tame0001/circuit/README.md

# CircuitDesign
Repository to keep electronics circuit design
