tame0001/circuit/LED/led_v1/led_v1.kicad_pcb

## KiCad design LED/led_v1/led_v1.kicad_pcb (2022-02-28)

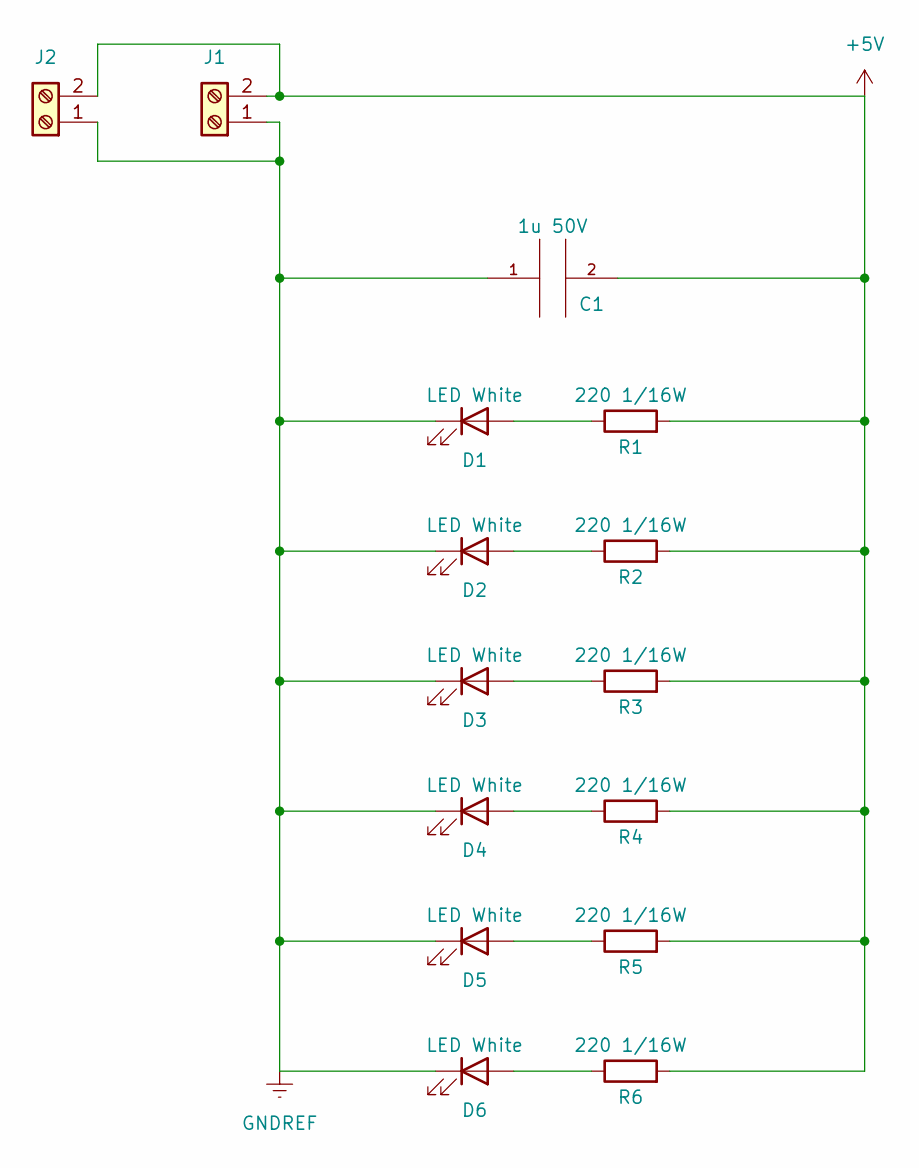
[picture p1: schematic led_v1.kicad_sch, LED Strip]

Parts:
C1: 1u 50V; C_0805_2012Metric; Part Number CL21B105KBFNNNE; JLC 0805
D1, D2, D3, D4, D5, D6: LED White; LED_0603_1608Metric; Part Number 19-217/T1D-CQ2R2TY/3T; JLC LED_0603
J1, J2: Screw_Terminal_01x02; TerminalBlock_Phoenix_MKDS-1,5-2-5.08_1x02_P5.08mm_Horizont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
R1, R2, R3, R4, R5, R6: 220 1/16W; R_0402_1005Metric; Part Number 0402WGF2200TCE; JLC 0402

Connections:
+5V: C1.2, J1.2, J2.2, R1.2, R2.2, R3.2, R4.2, R5.2, R6.2
GNDREF: C1.1, D1.1 (K), D2.1 (K), D3.1 (K), D4.1 (K), D5.1 (K), D6.1 (K), J1.1, J2.1
unnamed: D1.2 (A), R1.1
unnamed: D2.2 (A), R2.1
unnamed: D3.2 (A), R3.1
unnamed: D4.2 (A), R4.1
unnamed: D5.2 (A), R5.1
unnamed: D6.2 (A), R6.1

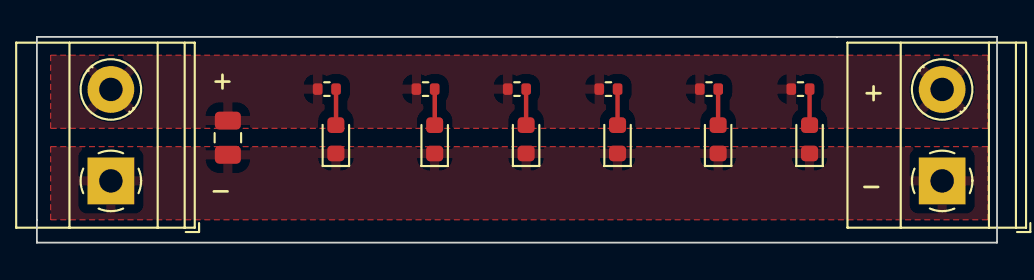
[picture p2: board led_v1.kicad_pcb from above]

Board: 2 copper layers, 53.3 x 11.4 mm, 15 parts (0 on the bottom side), 8 nets.
