tame0001/circuit/(commit log)

2020-07-15 Add symbols and footprints
2021-01-02 Create template for Arduino project
    [Arduino.kicad_pcb, Arduino.sch]
2021-01-02 Add main processor
    [Arduino.sch]
2021-01-04 Add 16 crystal
    [Arduino.sch]
2021-01-06 add capacitors for crystal
    [Arduino.sch]
2021-01-06 connect pin to MCU
    [Arduino.sch]
2021-01-07 Add linear regulator
    [Arduino.sch]
2021-01-08 Select n-mosfet for building relay
    [Arduino.sch]
2022-02-24 Remove old files
    [Arduino.kicad_pcb, Arduino.sch, led_v1.kicad_pcb, led_v1.kicad_sch]
2022-02-24 led version schematic
    [led_v1.kicad_sch]
2022-02-28 Send order for v1
    [led_v1.kicad_pcb, led_v1.kicad_sch]
